spilliams/tenet/writers-brick/brick_display_bb.png

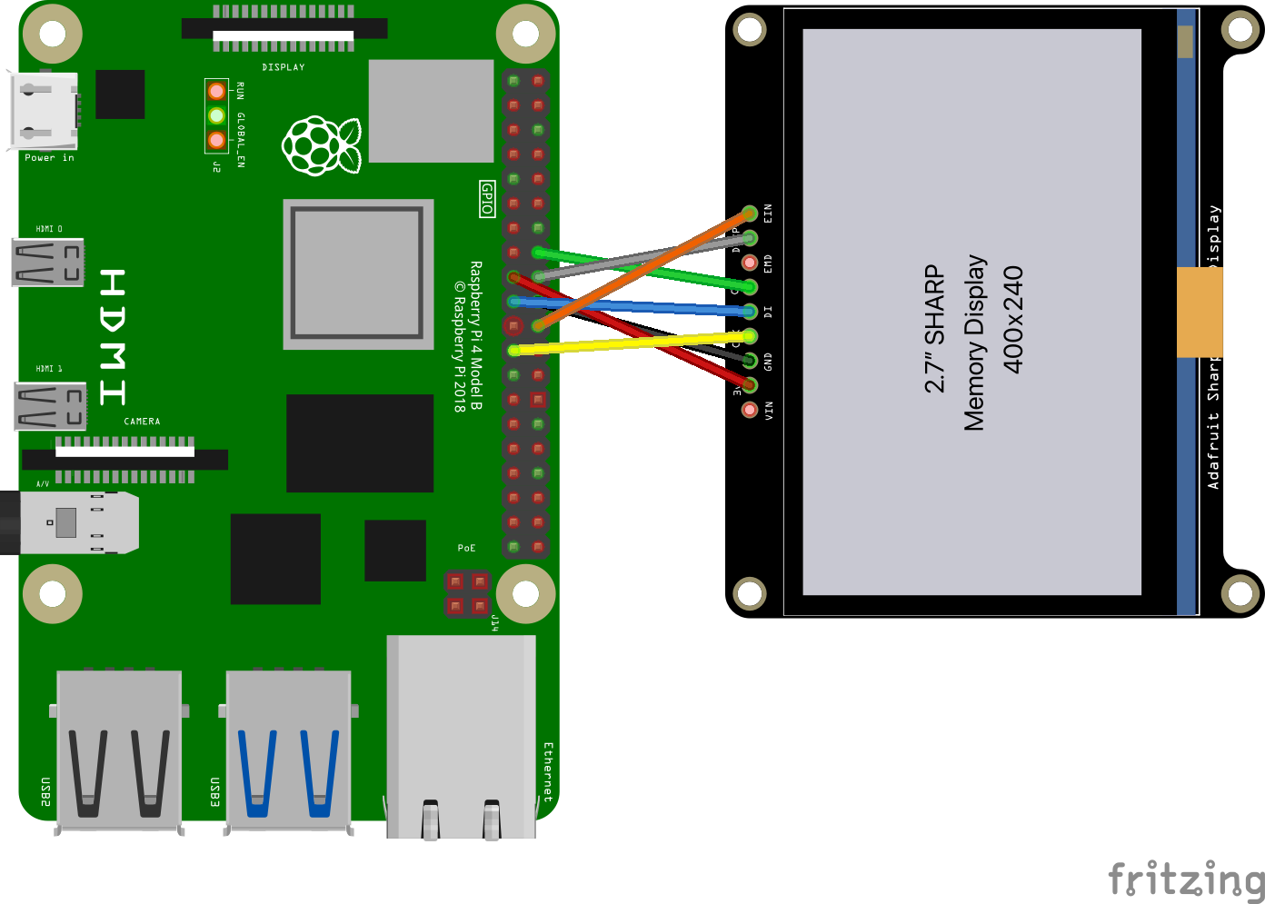
writers-brick/brick_display_bb.png
