spilliams/tenet/writers-brick/brick_power_bb.png

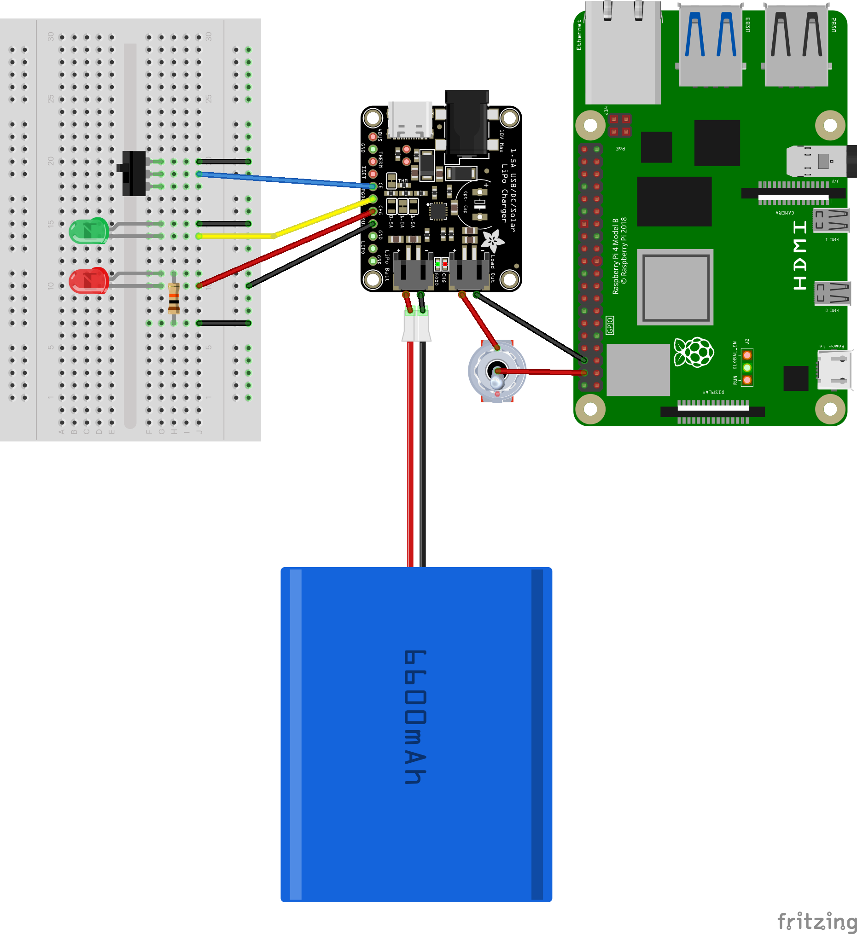
writers-brick/brick_power_bb.png
