spilliams/tenet/PCB/random-keyboard-parts.pretty-master/JST-SR-4.step

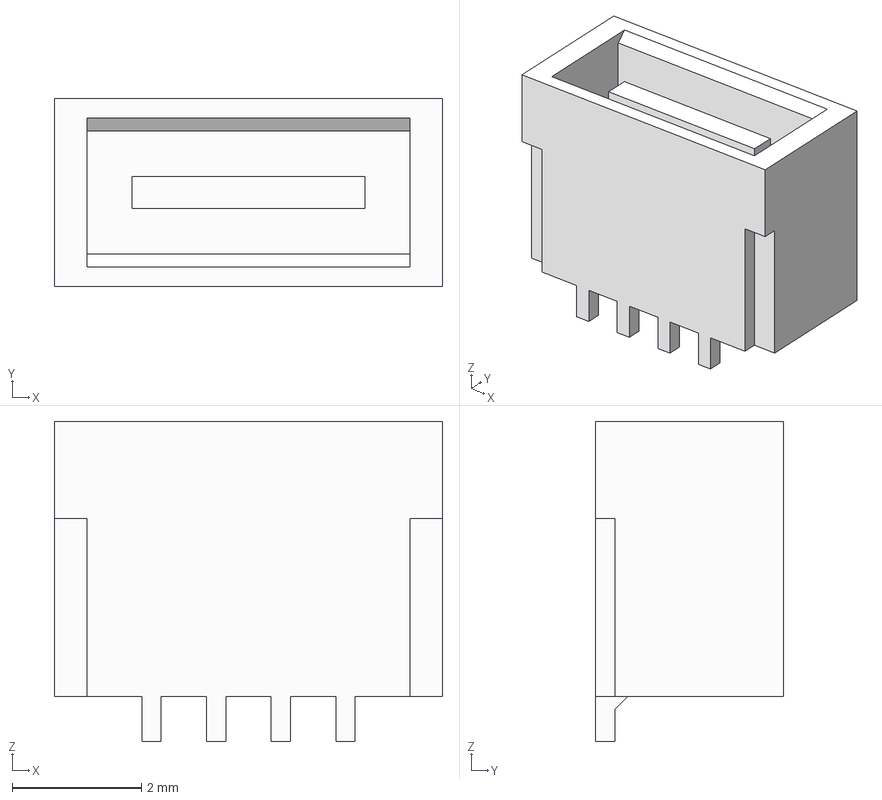
[picture p28: CAD file, 2023-08-20]
PCB/random-keyboard-parts.pretty-master/JST-SR-4.step
6.00 x 2.90 x 4.95 mm
