spilliams/tenet/writers-brick/enclosure_v1-power 3v4.stl

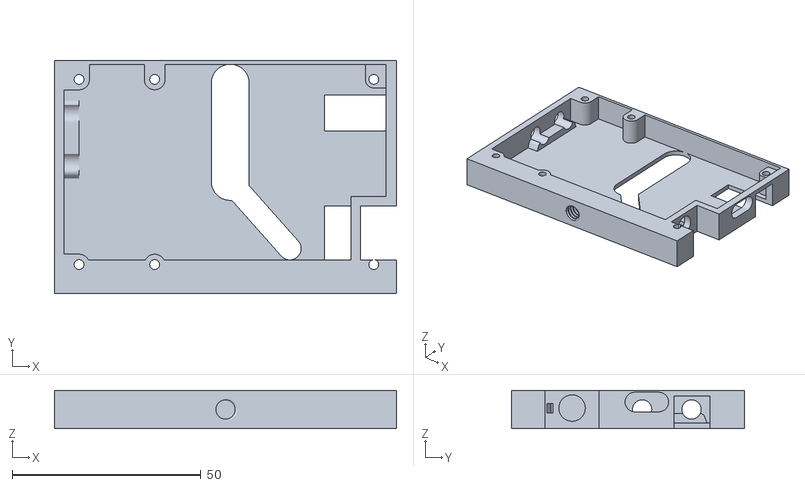
[picture p29: CAD file, 2023-01-28]
writers-brick/enclosure_v1-power 3v4.stl
90.5 x 61.7 x 10.1
