spilliams/tenet/3dp/v1.FCStd

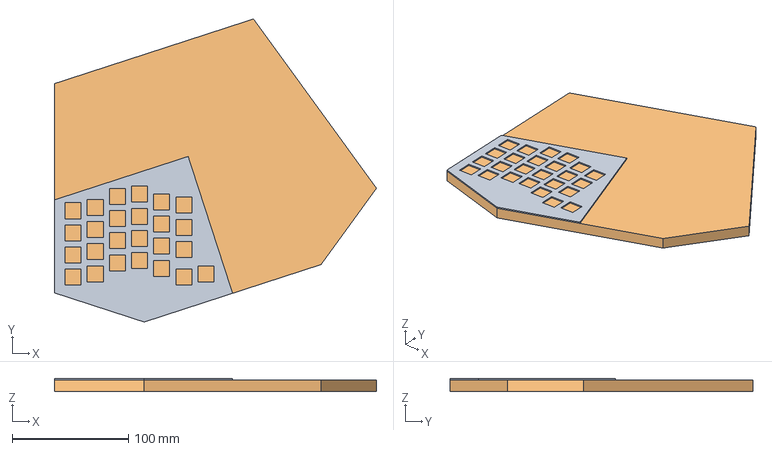
[picture p30: CAD file, 2023-08-21]
3dp/v1.FCStd
277.0 x 260.7 x 11.2 mm
switchplate
bottom shell
