spilliams/tenet/PCB/random-keyboard-parts.pretty-master/PJ-3200B.step

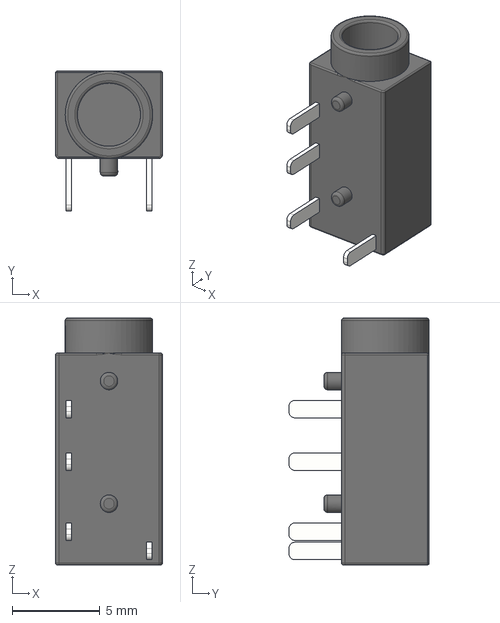
[picture p31: CAD file, 2023-08-20]
PCB/random-keyboard-parts.pretty-master/PJ-3200B.step
6.10 x 8.00 x 14.1 mm
