spilliams/tenet/writers-brick/enclosure_v1-battery 1v1.stl

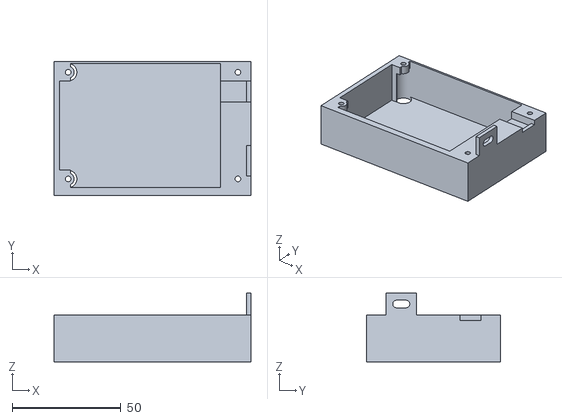
[picture p32: CAD file, 2023-01-28]
writers-brick/enclosure_v1-battery 1v1.stl
90.5 x 61.7 x 31.5
