spilliams/tenet/3dp/enclosure_v1-power 2v1.stl

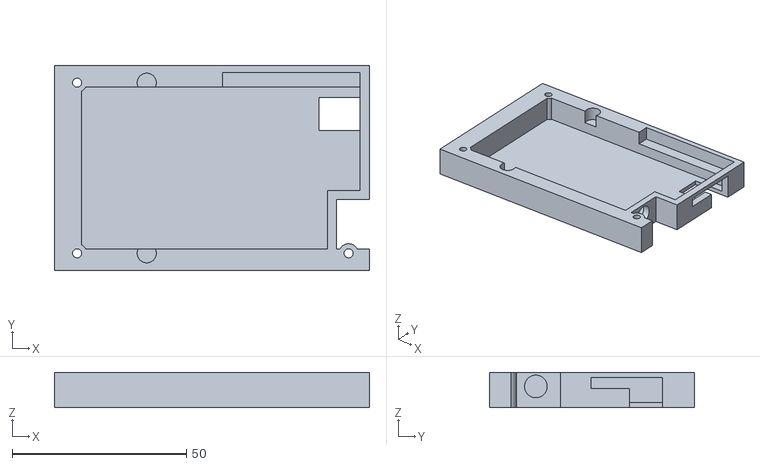
[picture p33: CAD file, 2023-01-28]
3dp/enclosure_v1-power 2v1.stl
90.5 x 59.0 x 10.1
