spilliams/tenet/PCB/random-keyboard-parts.pretty-master/Molex-0548190519.step

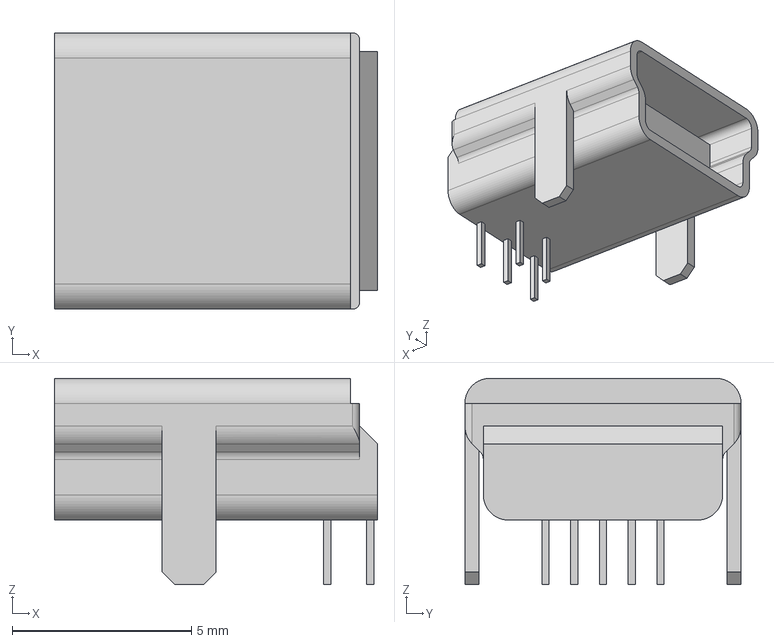
[picture p34: CAD file, 2023-08-20]
PCB/random-keyboard-parts.pretty-master/Molex-0548190519.step
9.00 x 7.70 x 5.75 mm
