spilliams/tenet/writers-brick/enclosure_v1-top 1v4.stl

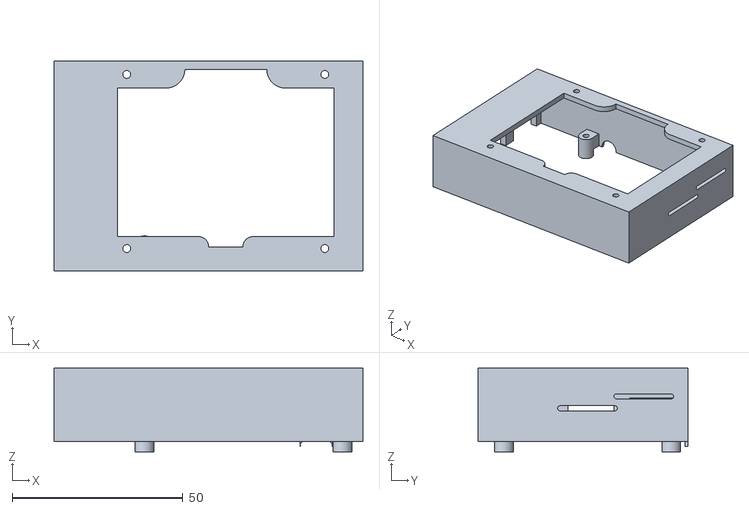
[picture p35: CAD file, 2023-01-28]
writers-brick/enclosure_v1-top 1v4.stl
90.5 x 61.7 x 24.5
