spilliams/tenet/3dp/v1-switchplate-rev3.stl

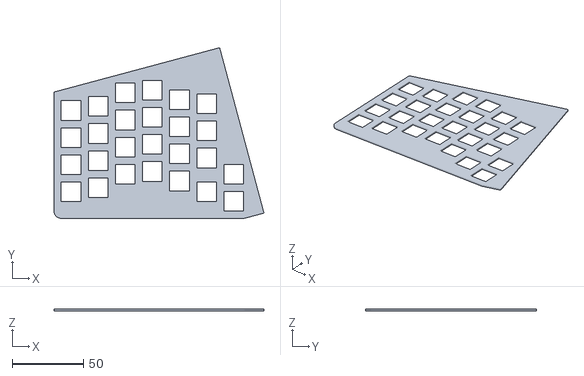
[picture p36: CAD file, 2023-01-28]
3dp/v1-switchplate-rev3.stl
147.4 x 119.8 x 1.25
