spilliams/tenet/PCB/random-keyboard-parts.pretty-master/JST-SR-3.step

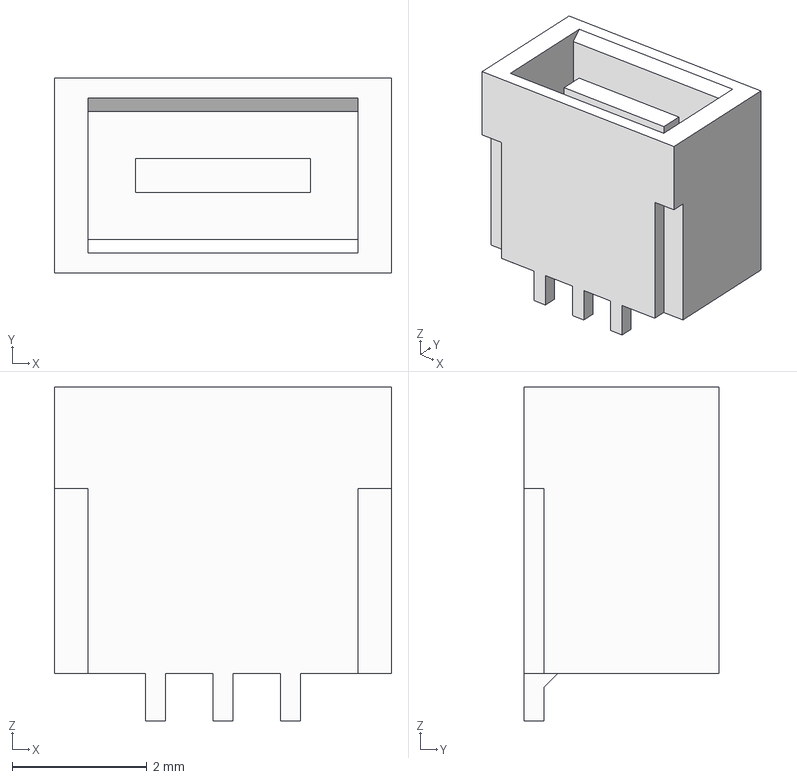
[picture p37: CAD file, 2023-08-20]
PCB/random-keyboard-parts.pretty-master/JST-SR-3.step
5.00 x 2.90 x 4.95 mm
