spilliams/tenet/writers-brick/enclosure_v1-frame2v7.stl

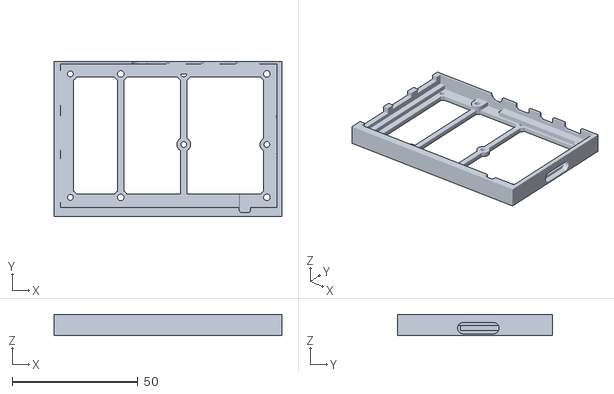
[picture p38: CAD file, 2023-01-28]
writers-brick/enclosure_v1-frame2v7.stl
90.5 x 61.7 x 8.50
