spilliams/tenet/3dp/enclosure_v1-top 1v3.stl

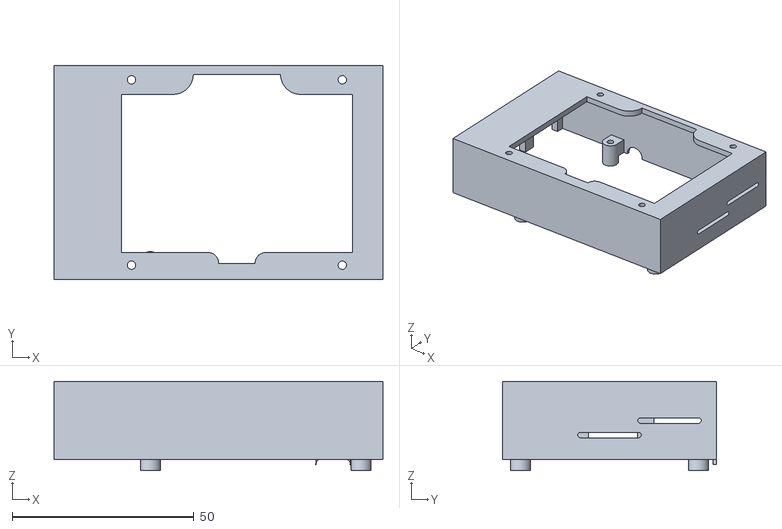
[picture p39: CAD file, 2023-01-28]
3dp/enclosure_v1-top 1v3.stl
90.5 x 59.0 x 24.5
