spilliams/tenet/3dp/enclosure_v1-test battery plate 1v1.stl

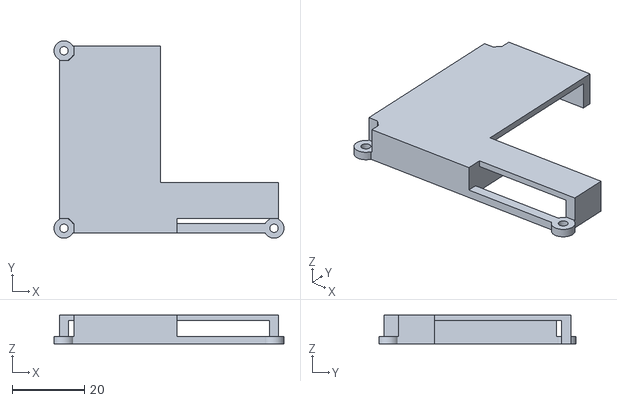
[picture p40: CAD file, 2023-01-28]
3dp/enclosure_v1-test battery plate 1v1.stl
63.5 x 54.5 x 8.00
