spilliams/tenet/3dp/enclosure_v1-frame 2v3.stl

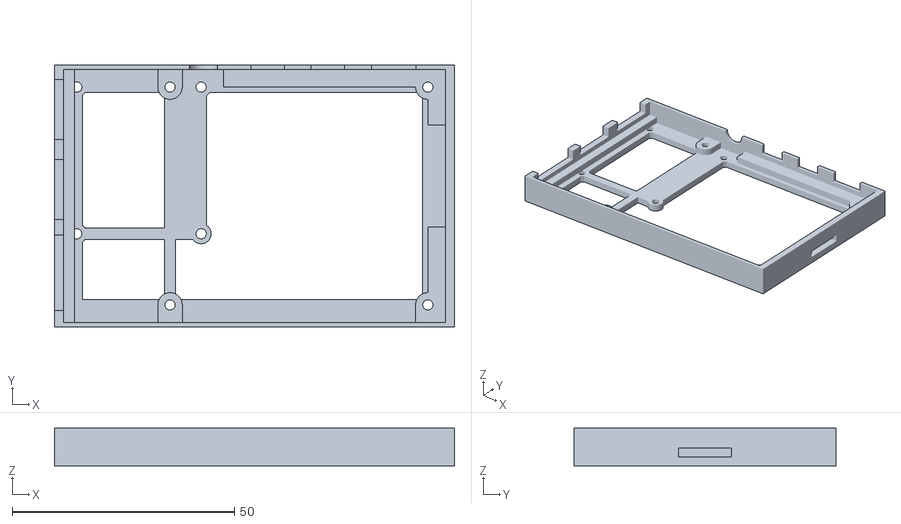
[picture p41: CAD file, 2023-01-28]
3dp/enclosure_v1-frame 2v3.stl
90.0 x 59.0 x 8.50
