spilliams/tenet/3dp/enclosure_v1-test power plate 1Pad003.stl

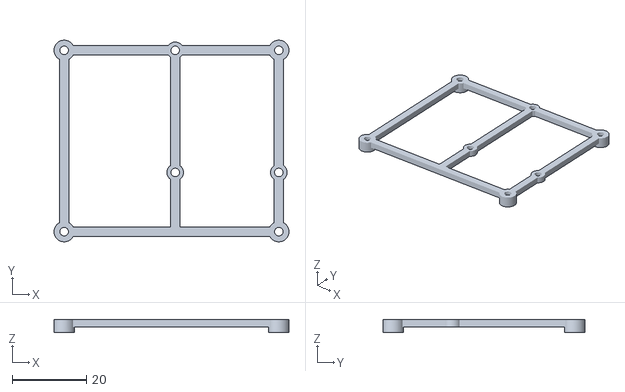
[picture p42: CAD file, 2023-01-28]
3dp/enclosure_v1-test power plate 1Pad003.stl
63.5 x 54.5 x 3.50
