spilliams/tenet/3dp/v1-switchplate-rev5-27degPentagon.stl

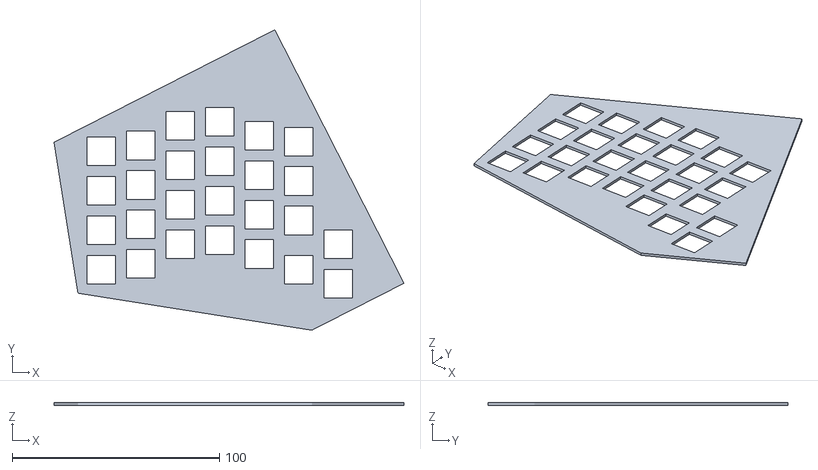
[picture p44: CAD file, 2023-01-28]
3dp/v1-switchplate-rev5-27degPentagon.stl
168.9 x 145.0 x 1.25
