spilliams/tenet/3dp/enclosure_v1.FCStd

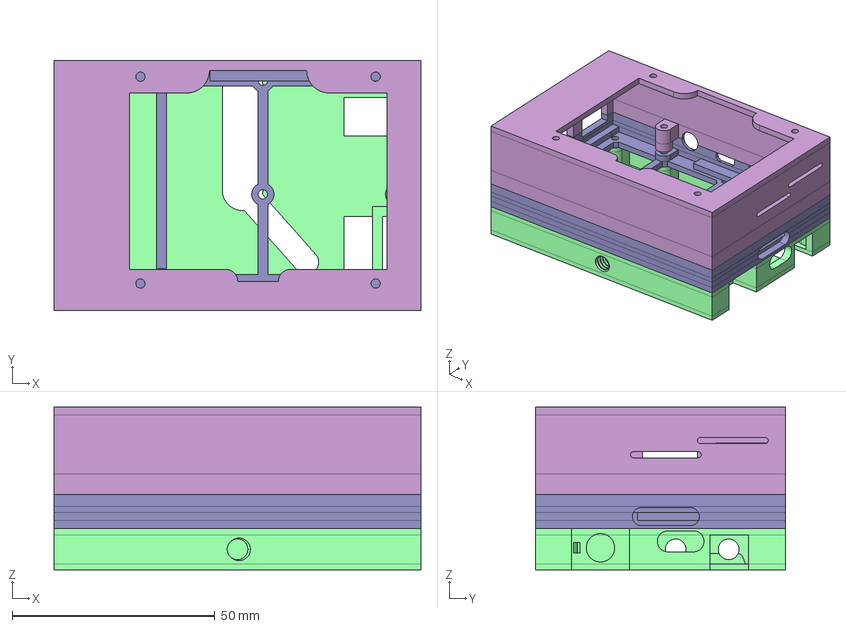
[picture p45: CAD file, 2023-01-28]
3dp/enclosure_v1.FCStd
90.5 x 61.7 x 40.2 mm
top 1
power 3
frame 2
