spilliams/tenet/3dp/enclosure_v1-frame 2v1.stl

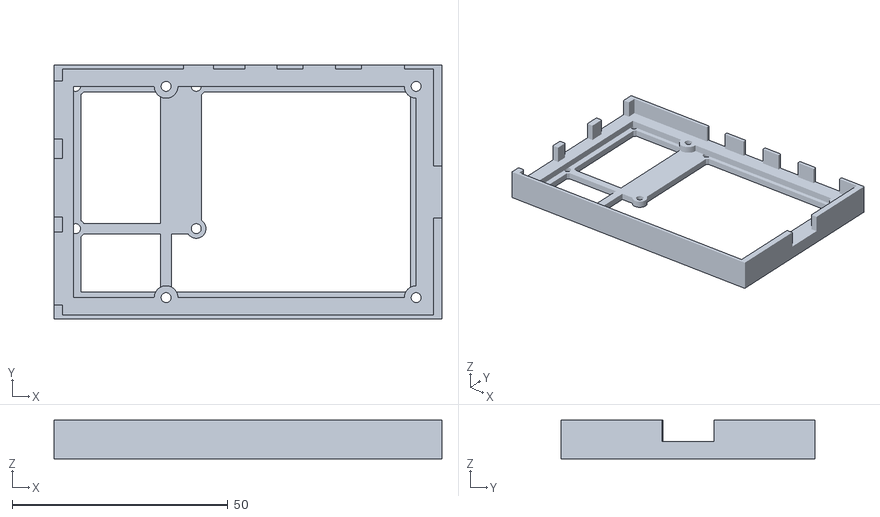
[picture p46: CAD file, 2023-01-28]
3dp/enclosure_v1-frame 2v1.stl
90.0 x 59.0 x 9.00
