spilliams/tenet/3dp/enclosure_v1-frame 2v4.stl

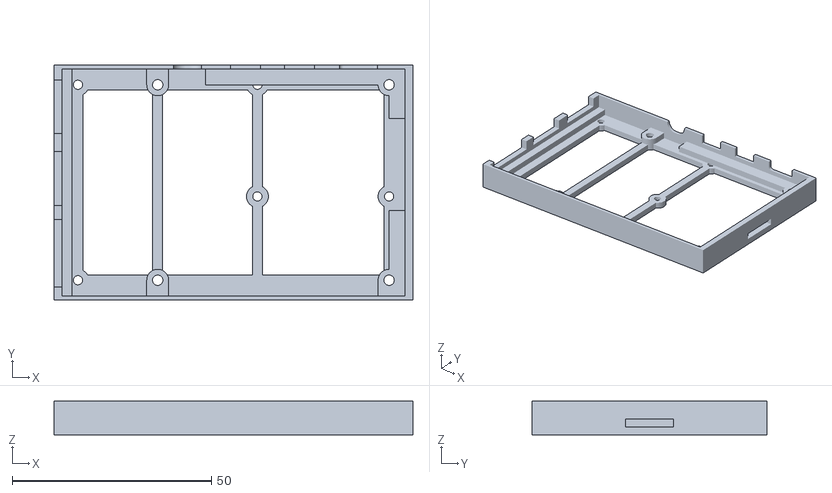
[picture p47: CAD file, 2023-01-28]
3dp/enclosure_v1-frame 2v4.stl
90.0 x 59.0 x 8.50
