spilliams/tenet/3dp/enclosure_v1 - Backup.FCStd

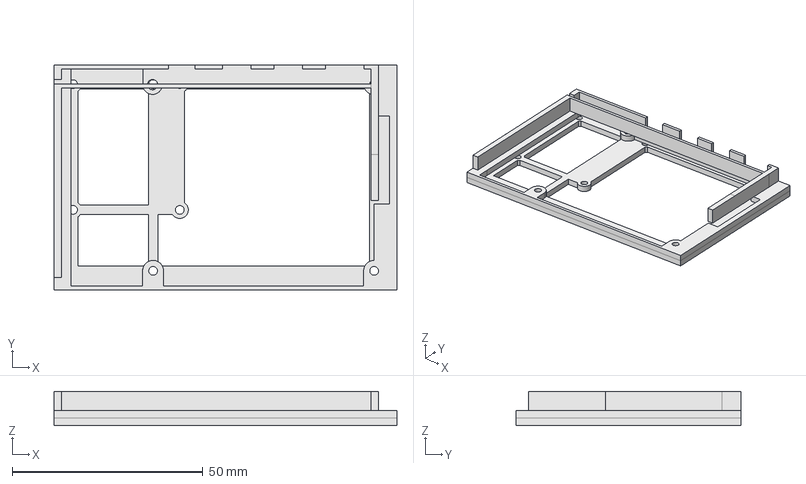
[picture p48: CAD file, 2023-01-28]
3dp/enclosure_v1 - Backup.FCStd
90.0 x 59.0 x 9.00 mm
