spilliams/tenet/3dp/v1-switchplate-rev2.stl

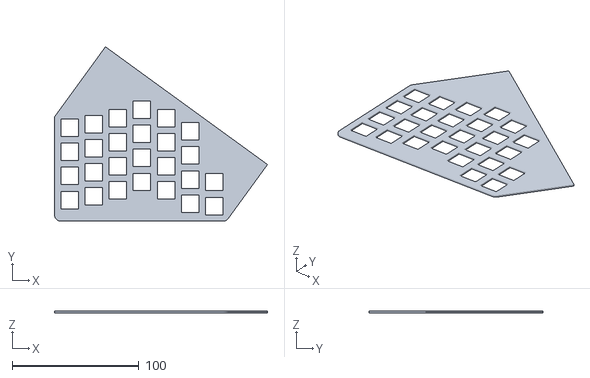
[picture p49: CAD file, 2023-01-28]
3dp/v1-switchplate-rev2.stl
168.1 x 137.7 x 1.25
