spilliams/tenet/3dp/v1-switchplate-rev6-18deg.stl

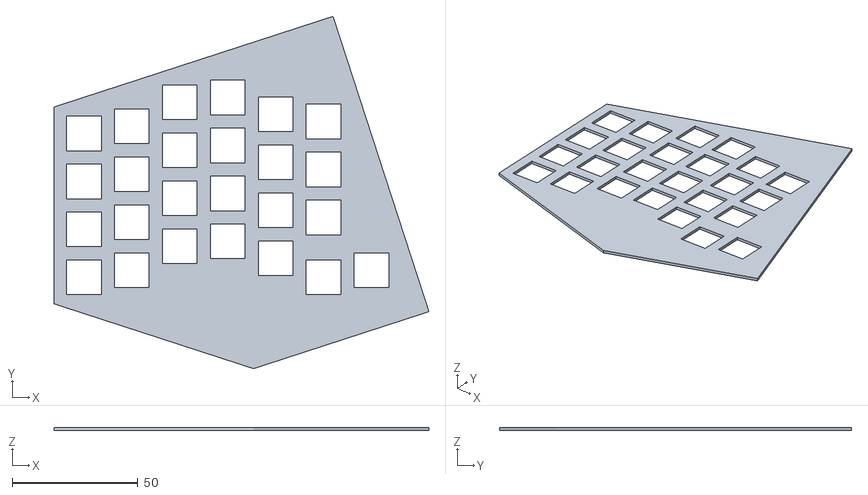
[picture p50: CAD file, 2023-01-28]
3dp/v1-switchplate-rev6-18deg.stl
149.1 x 140.0 x 1.25
