spilliams/tenet/3dp/enclosure_v1-test display plate 1v2.stl

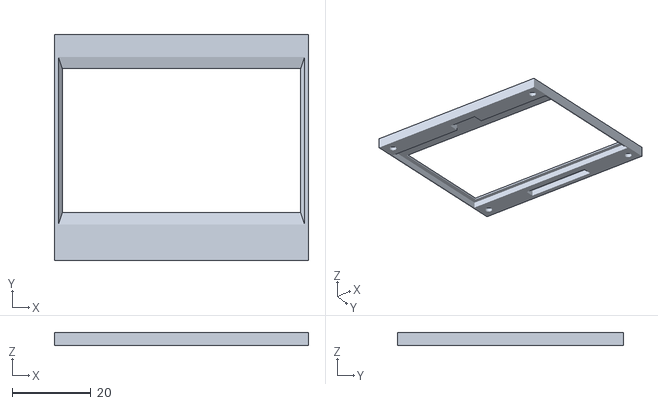
[picture p51: CAD file, 2023-01-28]
3dp/enclosure_v1-test display plate 1v2.stl
64.5 x 57.5 x 3.35
