spilliams/tenet/3dp/v1-switchplate.stl

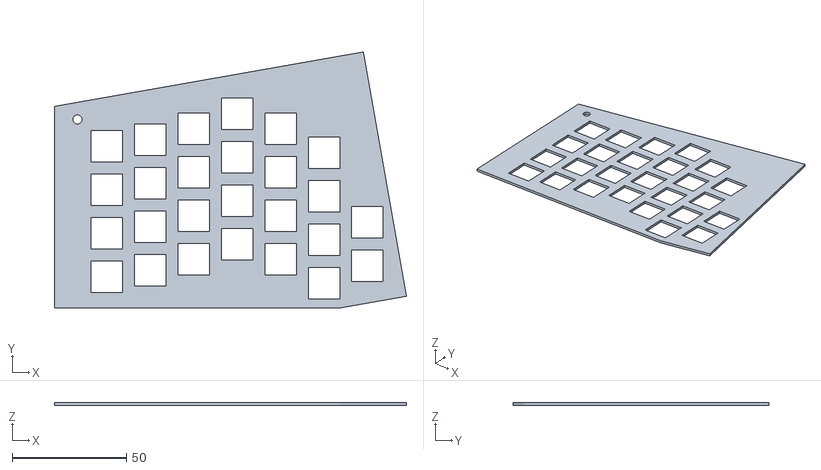
[picture p53: CAD file, 2023-01-28]
3dp/v1-switchplate.stl
154.3 x 112.3 x 1.30
