spilliams/tenet/3dp/enclosure_v1-top 1v2.stl

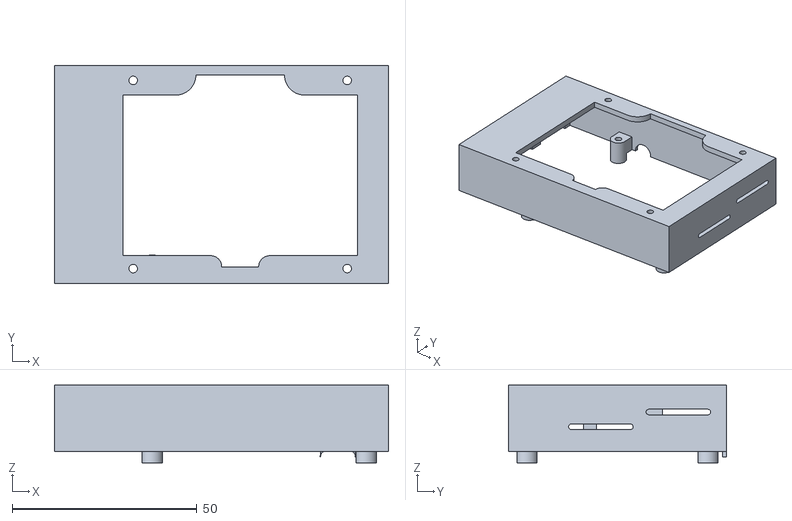
[picture p54: CAD file, 2023-01-28]
3dp/enclosure_v1-top 1v2.stl
90.5 x 59.0 x 21.0
