spilliams/tenet/3dp/enclosure_v1-test display plate 1Chamfer001.stl

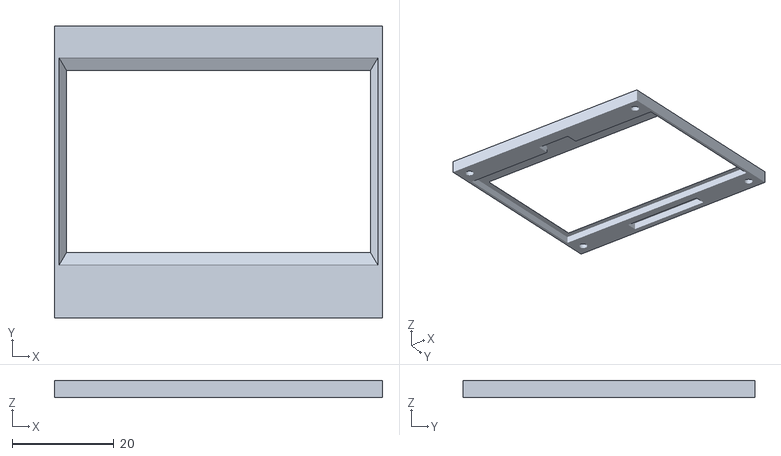
[picture p55: CAD file, 2023-01-28]
3dp/enclosure_v1-test display plate 1Chamfer001.stl
64.5 x 57.5 x 3.35
