spilliams/tenet/3dp/enclosure_v1-test power plate 1v2.stl

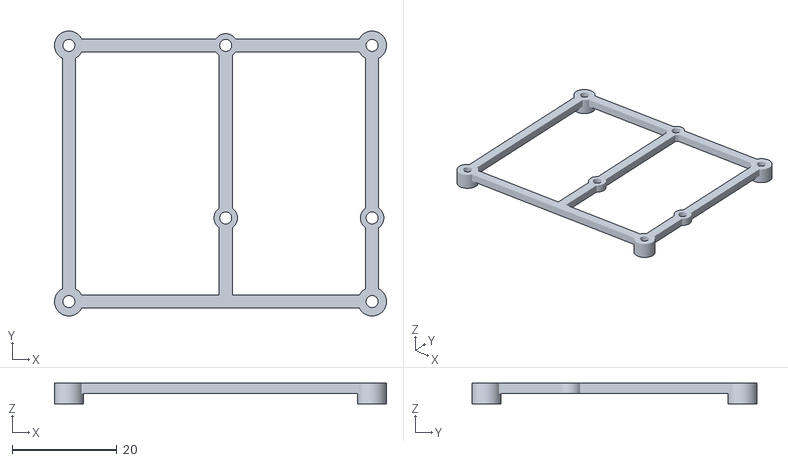
[picture p56: CAD file, 2023-01-28]
3dp/enclosure_v1-test power plate 1v2.stl
63.5 x 54.5 x 4.00
