spilliams/tenet/3dp/enclosure_v1-frame 2v2.stl

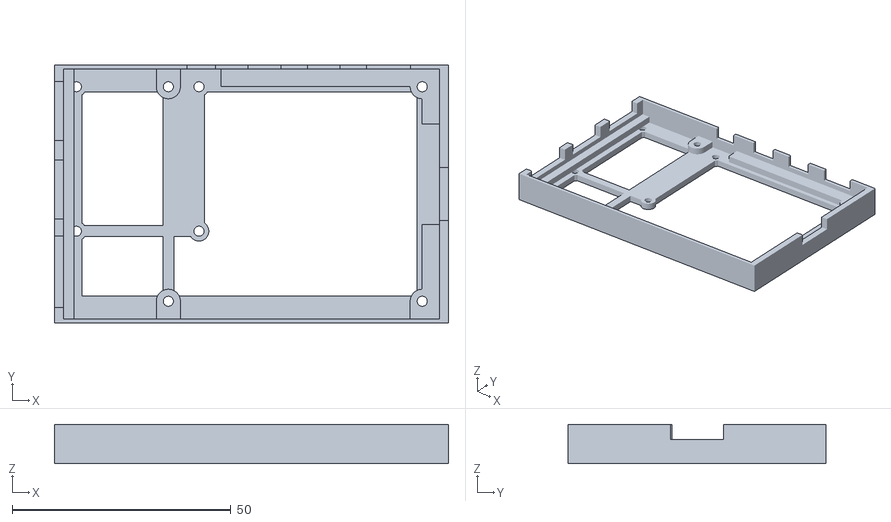
[picture p57: CAD file, 2023-01-28]
3dp/enclosure_v1-frame 2v2.stl
90.0 x 59.0 x 9.00
