spilliams/tenet/3dp/v1-switchplate-rev4-15degPentagon.stl

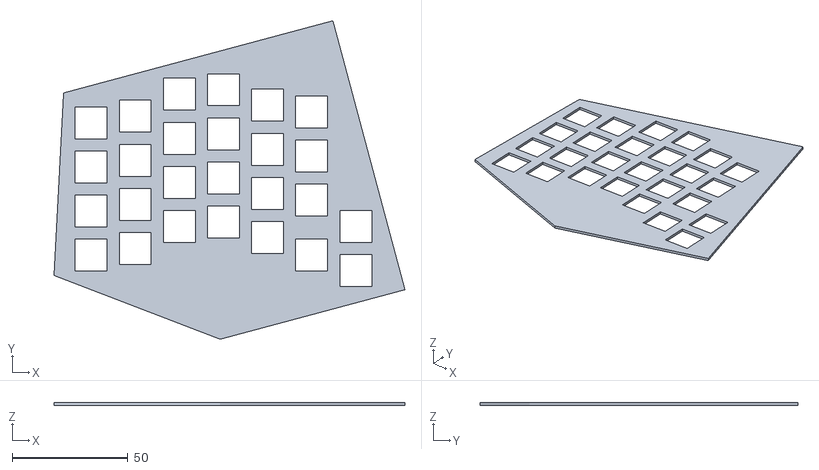
[picture p58: CAD file, 2023-01-28]
3dp/v1-switchplate-rev4-15degPentagon.stl
151.6 x 137.5 x 1.25
