spilliams/tenet/(list of files, cad)

Other CAD files:
3dp/tenet_mechanism.FCStd
3dp/enclosure_v1-power 3v3.stl
3dp/enclosure_v1-frame 2v6.stl
3dp/enclosure_v1-frame 2v5.stl
