spilliams/tenet/notes/sharp_display_instructions.md

# Sharp Memory Display instructions

Starting materials:

- (1) Raspberry Pi, running Raspbian
- (1) [Adafruit SHARP Memory Display Breakout](https://www.adafruit.com/product/4694)
- (1) breadboard
- breadboard wires
- (Optional) Pi Cobbler or other pi breakout helper

## Wiring Diagram

## Pi Config
