spilliams/tenet/writers-brick/build_guide.md

# "Writer's Brick" Build Guide

See here: https://spencerenglish.net/articles/20230126_tenet_brick/
