spilliams/tenet/(list of files, drawings)

Other design files:
writers-brick/brick_display.fzz
writers-brick/brick_power.fzz
