spilliams/tenet/PCB/kicads/tenet-kb-1.kicad_pcb

## KiCad design PCB/kicads/tenet-kb-1.kicad_pcb (2023-08-21)

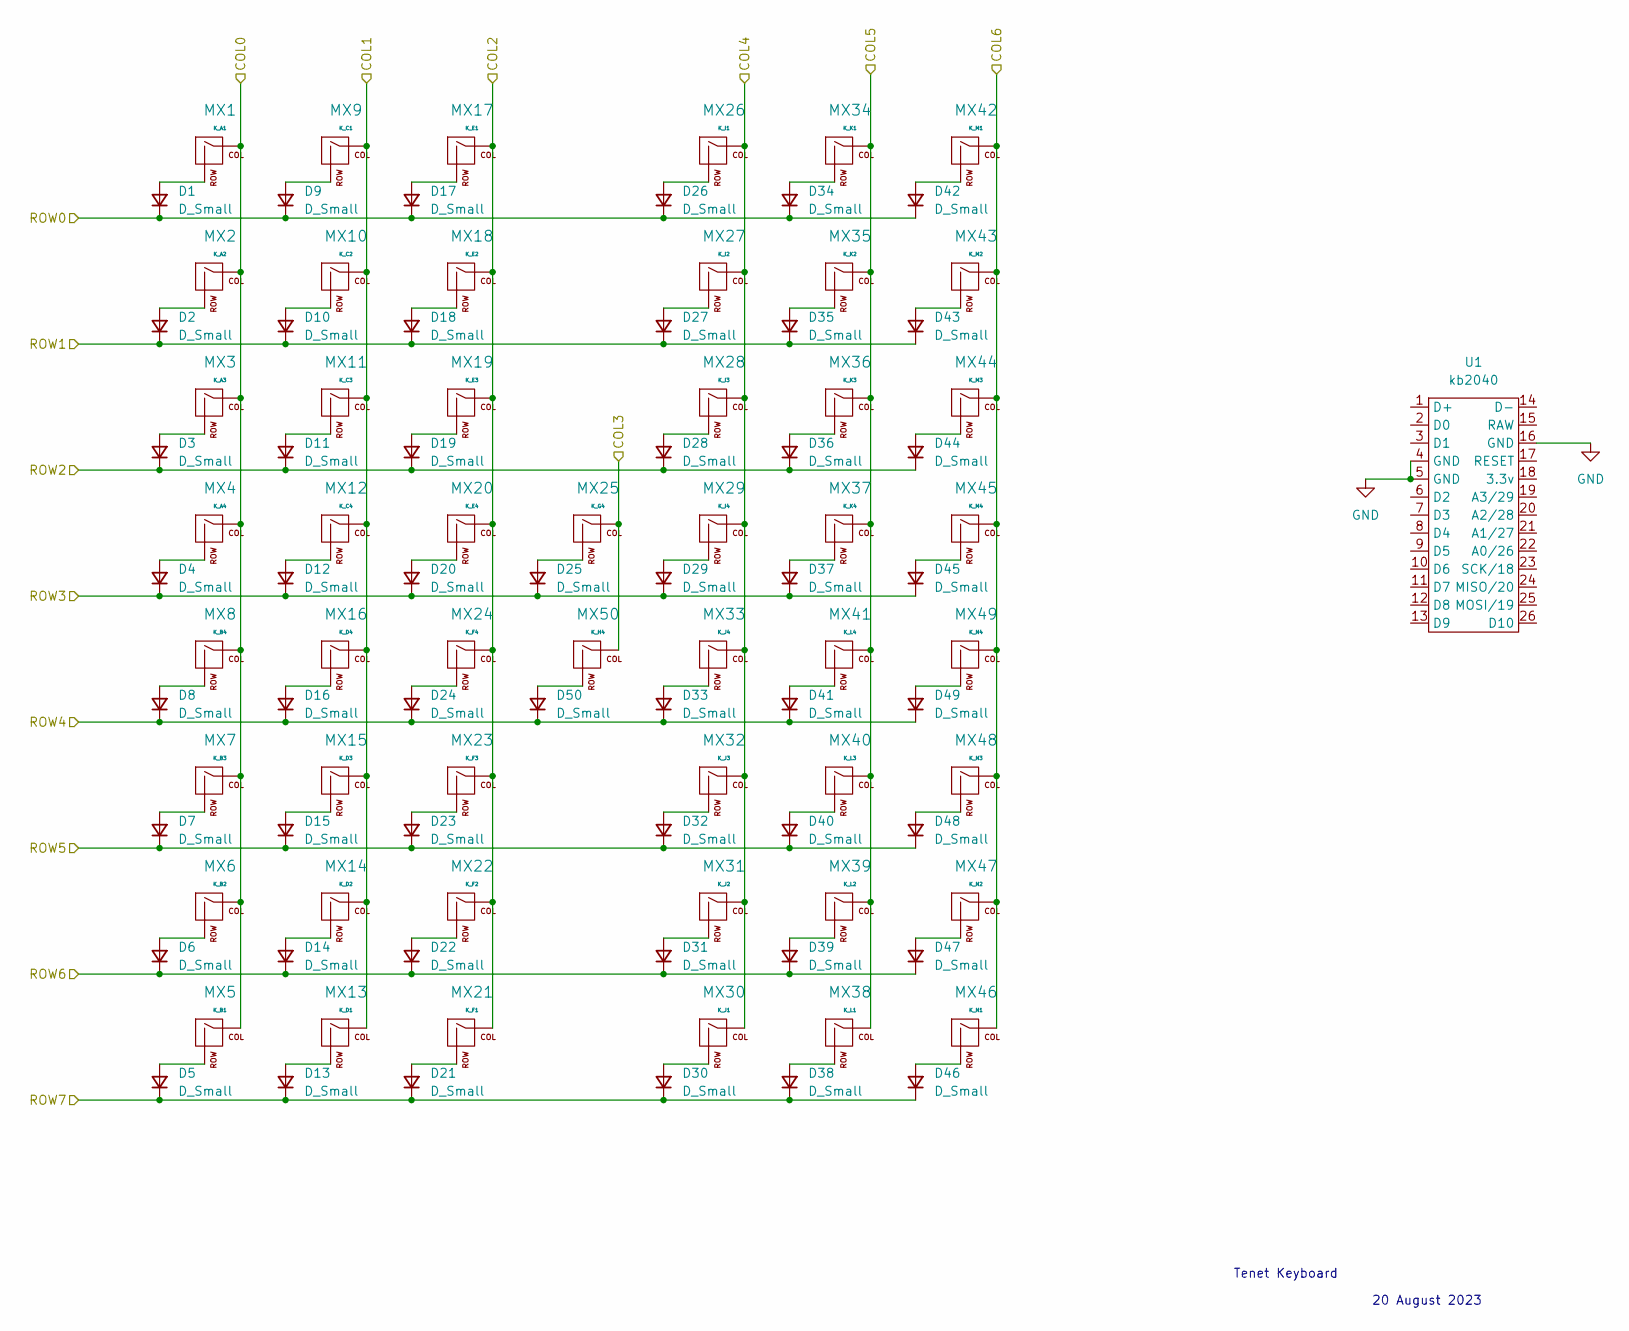
[picture p59: schematic tenet-kb-1.kicad_sch]

Parts:
D1, D2, D3, D4, D5, D6, D7, D8, D9, D10, D11, D12, D13, D14, D15, D16, D17, D18, D19, D20, D21, D22, D23, D24, D25, D26, D27, D28, D29, D30, D31, D32, D33, D34, D35, D36, D37, D38, D39, D40, D41, D42, D43, D44, D45, D46, D47, D48, D49, D50: D_Small; D_SOD-123
MX1: K_A1; Kailh_socket_PG1350
MX2: K_A2; Kailh_socket_PG1350
MX3: K_A3; Kailh_socket_PG1350
MX4: K_A4; Kailh_socket_PG1350
MX5: K_B1; Kailh_socket_PG1350
MX6: K_B2; Kailh_socket_PG1350
MX7: K_B3; Kailh_socket_PG1350
MX8: K_B4; Kailh_socket_PG1350
MX9: K_C1; Kailh_socket_PG1350
MX10: K_C2; Kailh_socket_PG1350
MX11: K_C3; Kailh_socket_PG1350
MX12: K_C4; Kailh_socket_PG1350
MX13: K_D1; Kailh_socket_PG1350
MX14: K_D2; Kailh_socket_PG1350
MX15: K_D3; Kailh_socket_PG1350
MX16: K_D4; Kailh_socket_PG1350
MX17: K_E1; Kailh_socket_PG1350
MX18: K_E2; Kailh_socket_PG1350
MX19: K_E3; Kailh_socket_PG1350
MX20: K_E4; Kailh_socket_PG1350
MX21: K_F1; Kailh_socket_PG1350
MX22: K_F2; Kailh_socket_PG1350
MX23: K_F3; Kailh_socket_PG1350
MX24: K_F4; Kailh_socket_PG1350
MX25: K_G4; Kailh_socket_PG1350
MX26: K_I1; Kailh_socket_PG1350
MX27: K_I2; Kailh_socket_PG1350
MX28: K_I3; Kailh_socket_PG1350
MX29: K_I4; Kailh_socket_PG1350
MX30: K_J1; Kailh_socket_PG1350
MX31: K_J2; Kailh_socket_PG1350
MX32: K_J3; Kailh_socket_PG1350
MX33: K_J4; Kailh_socket_PG1350
MX34: K_K1; Kailh_socket_PG1350
MX35: K_K2; Kailh_socket_PG1350
MX36: K_K3; Kailh_socket_PG1350
MX37: K_K4; Kailh_socket_PG1350
MX38: K_L1; Kailh_socket_PG1350
MX39: K_L2; Kailh_socket_PG1350
MX40: K_L3; Kailh_socket_PG1350
MX41: K_L4; Kailh_socket_PG1350
MX42: K_M1; Kailh_socket_PG1350
MX43: K_M2; Kailh_socket_PG1350
MX44: K_M3; Kailh_socket_PG1350
MX45: K_M4; Kailh_socket_PG1350
MX46: K_N1; Kailh_socket_PG1350
MX47: K_N2; Kailh_socket_PG1350
MX48: K_N3; Kailh_socket_PG1350
MX49: K_N4; Kailh_socket_PG1350
MX50: K_H4; Kailh_socket_PG1350
U1: kb2040

Connections:
3.3V: U1.17 (RESET)
/COL0: MX1.1 (COL), MX2.1 (COL), MX3.1 (COL), MX4.1 (COL), MX5.1 (COL), MX6.1 (COL), MX7.1 (COL), MX8.1 (COL), U1.18 (3.3v)
/COL1: MX9.1 (COL), MX10.1 (COL), MX11.1 (COL), MX12.1 (COL), MX13.1 (COL), MX14.1 (COL), MX15.1 (COL), MX16.1 (COL), U1.20 (A2/28)
/COL2: MX17.1 (COL), MX18.1 (COL), MX19.1 (COL), MX20.1 (COL), MX21.1 (COL), MX22.1 (COL), MX23.1 (COL), MX24.1 (COL), U1.11 (D7)
/COL3: MX25.1 (COL), MX50.1 (COL), U1.13 (D9)
/COL4: MX26.1 (COL), MX27.1 (COL), MX28.1 (COL), MX29.1 (COL), MX30.1 (COL), MX31.1 (COL), MX32.1 (COL), MX33.1 (COL), U1.9 (D5)
/COL5: MX34.1 (COL), MX35.1 (COL), MX36.1 (COL), MX37.1 (COL), MX38.1 (COL), MX39.1 (COL), MX40.1 (COL), MX41.1 (COL), U1.6 (D2)
/COL6: MX42.1 (COL), MX43.1 (COL), MX44.1 (COL), MX45.1 (COL), MX46.1 (COL), MX47.1 (COL), MX48.1 (COL), MX49.1 (COL), U1.2 (D0)
/ROW0: D1.1 (K), D9.1 (K), D17.1 (K), D26.1 (K), D34.1 (K), D42.1 (K), U1.16 (GND)
/ROW1: D2.1 (K), D10.1 (K), D18.1 (K), D27.1 (K), D35.1 (K), D43.1 (K), U1.8 (D4)
/ROW2: D3.1 (K), D11.1 (K), D19.1 (K), D28.1 (K), D36.1 (K), D44.1 (K), U1.12 (D8)
/ROW3: D4.1 (K), D12.1 (K), D20.1 (K), D25.1 (K), D29.1 (K), D37.1 (K), D45.1 (K), U1.7 (D3)
/ROW4: D8.1 (K), D16.1 (K), D24.1 (K), D33.1 (K), D41.1 (K), D49.1 (K), D50.1 (K), U1.13 (D9)
/ROW5: D7.1 (K), D15.1 (K), D23.1 (K), D32.1 (K), D40.1 (K), D48.1 (K), U1.10 (D6)
/ROW6: D6.1 (K), D14.1 (K), D22.1 (K), D31.1 (K), D39.1 (K), D47.1 (K), U1.3 (D1)
/ROW7: D5.1 (K), D13.1 (K), D21.1 (K), D30.1 (K), D38.1 (K), D46.1 (K), U1.19 (A3/29)
unnamed: D1.2 (A), MX1.2 (ROW)
unnamed: D2.2 (A), MX2.2 (ROW)
unnamed: D3.2 (A), MX3.2 (ROW)
unnamed: D4.2 (A), MX4.2 (ROW)
unnamed: D5.2 (A), MX5.2 (ROW)
unnamed: D6.2 (A), MX6.2 (ROW)
unnamed: D7.2 (A), MX7.2 (ROW)
unnamed: D8.2 (A), MX8.2 (ROW)
unnamed: D9.2 (A), MX9.2 (ROW)
unnamed: D10.2 (A), MX10.2 (ROW)
unnamed: D11.2 (A), MX11.2 (ROW)
unnamed: D12.2 (A), MX12.2 (ROW)
unnamed: D13.2 (A), MX13.2 (ROW)
unnamed: D14.2 (A), MX14.2 (ROW)
unnamed: D15.2 (A), MX15.2 (ROW)
unnamed: D16.2 (A), MX16.2 (ROW)
unnamed: D17.2 (A), MX17.2 (ROW)
unnamed: D18.2 (A), MX18.2 (ROW)
unnamed: D19.2 (A), MX19.2 (ROW)
unnamed: D20.2 (A), MX20.2 (ROW)
unnamed: D21.2 (A), MX21.2 (ROW)
unnamed: D22.2 (A), MX22.2 (ROW)
unnamed: D23.2 (A), MX23.2 (ROW)
unnamed: D24.2 (A), MX24.2 (ROW)
unnamed: D25.2 (A), MX25.2 (ROW)
unnamed: D26.2 (A), MX26.2 (ROW)
unnamed: D27.2 (A), MX27.2 (ROW)
unnamed: D28.2 (A), MX28.2 (ROW)
unnamed: D29.2 (A), MX29.2 (ROW)
unnamed: D30.2 (A), MX30.2 (ROW)
unnamed: D31.2 (A), MX31.2 (ROW)
unnamed: D32.2 (A), MX32.2 (ROW)
unnamed: D33.2 (A), MX33.2 (ROW)
unnamed: D34.2 (A), MX34.2 (ROW)
unnamed: D35.2 (A), MX35.2 (ROW)
unnamed: D36.2 (A), MX36.2 (ROW)
unnamed: D37.2 (A), MX37.2 (ROW)
unnamed: D38.2 (A), MX38.2 (ROW)
unnamed: D39.2 (A), MX39.2 (ROW)
unnamed: D40.2 (A), MX40.2 (ROW)
unnamed: D41.2 (A), MX41.2 (ROW)
unnamed: D42.2 (A), MX42.2 (ROW)
unnamed: D43.2 (A), MX43.2 (ROW)
unnamed: D44.2 (A), MX44.2 (ROW)
unnamed: D45.2 (A), MX45.2 (ROW)
unnamed: D46.2 (A), MX46.2 (ROW)
unnamed: D47.2 (A), MX47.2 (ROW)
unnamed: D48.2 (A), MX48.2 (ROW)
unnamed: D49.2 (A), MX49.2 (ROW)
unnamed: D50.2 (A), MX50.2 (ROW)

Notes on the sheet:
20 August 2023
Tenet Keyboard

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
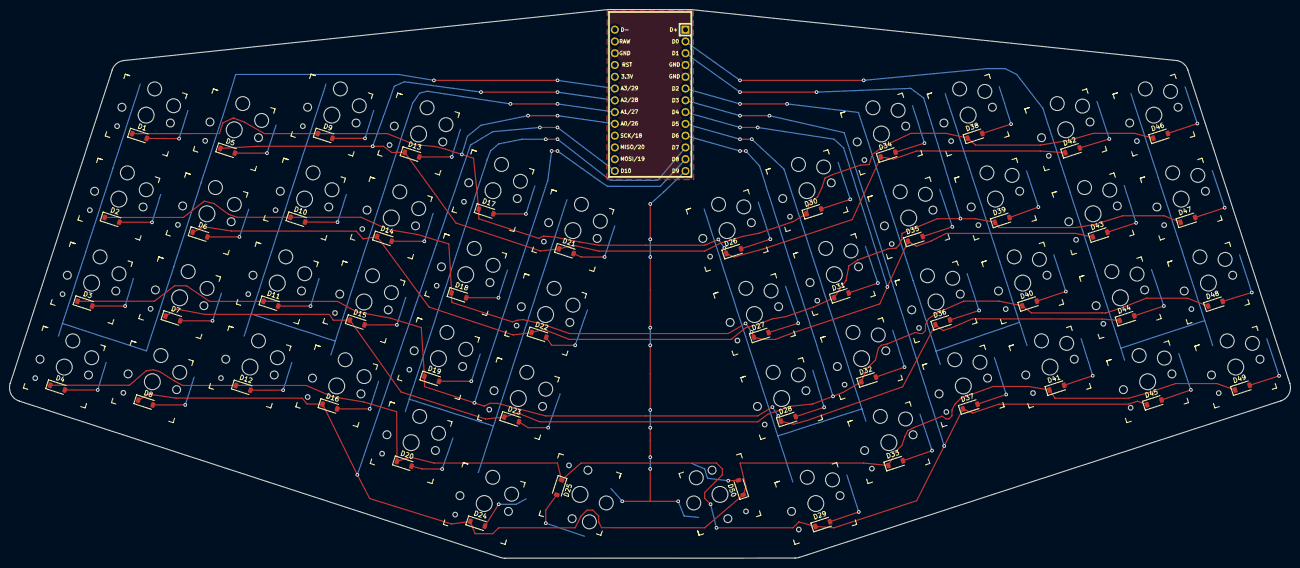
[picture p60: board tenet-kb-1.kicad_pcb from above]

Board: 2 copper layers, 276.3 x 118.4 mm, 101 parts (1 on the bottom side), 66 nets.
