spilliams/tenet/(commit log)

2022-08-29 first switchplate
    [v1-switchplate.stl, v1.FCStd]
2022-08-30 54 degrees is too much; and other tweaks
    [v1-switchplate-rev3.stl, v1.FCStd]
2022-11-26 display woes vanquished
    [sharpikeebo_bom.csv, sharpikeebo_bom_lcscref.csv]
2023-01-28 getting ready to publish
    [config.txt]
2023-01-28 3d files
    [enclosure_v1 - Backup.FCStd, enclosure_v1-battery 1v1.stl, enclosure_v1-frame 2v1.stl, enclosure_v1-frame 2v2.stl, enclosure_v1-frame 2v3.stl, enclosure_v1-frame 2v4.stl, enclosure_v1-frame 2v5.stl, enclosure_v1-frame 2v6.stl]
2023-01-28 files for printing
2023-01-29 ready for publication
    [brick_display.fzz, brick_power.fzz]
2023-08-20 new empty KiCad project
    [tenet-kb-1.kicad_pcb, tenet-kb-1.kicad_sch]
2023-08-20 imported libraries
    [JST-SR-3.step, JST-SR-4.step, Molex-0548190519.step, PJ-3200B.step]
2023-08-20 MCU schematic
    [tenet-kb-1.kicad_sch]
2023-08-20 keyswitch schematics
    [tenet-kb-1.kicad_sch]
2023-08-20 footprints assigned
    [tenet-kb-1.kicad_sch]
2023-08-21 pcb 1, mostly done
    [5302 KB2040.step, tenet-kb-1.kicad_pcb, tenet-kb-1.kicad_sch, v1.FCStd]
2024-04-21 new design start
    [tenet-folio.kicad_pcb, tenet-folio.kicad_sch, tenet-kb-1.kicad_pcb, tenet-kb-1.kicad_sch, tenet_mechanism.FCStd]
